Makin-Things/ESPHome-Brivis-Networker/Doc/PCB/v1.1/Layout_v1.1.png

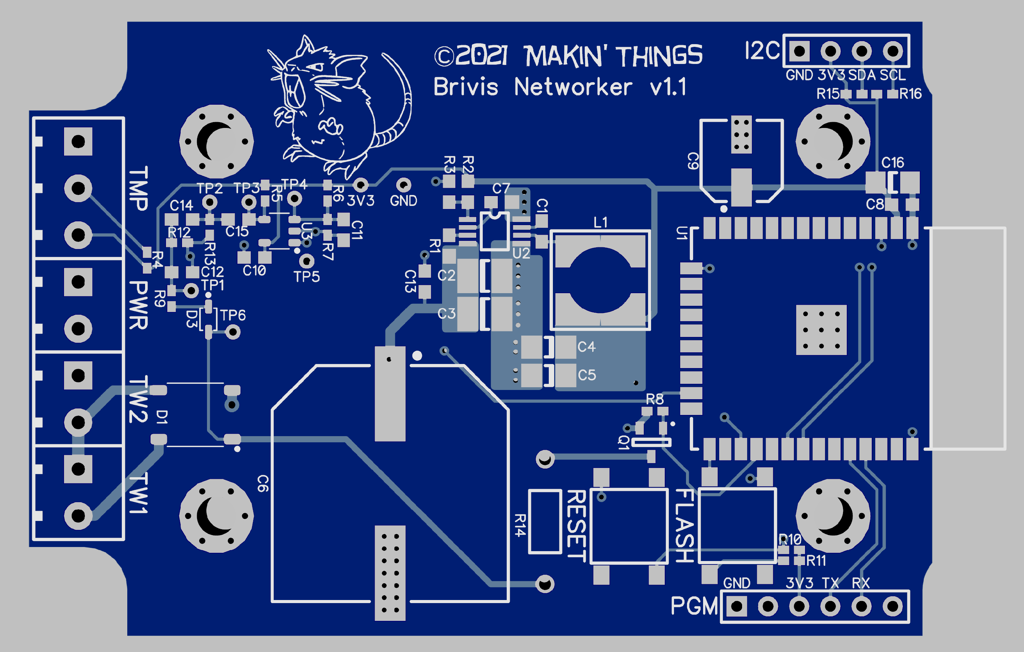
Doc/PCB/v1.1/Layout_v1.1.png
