Makin-Things/ESPHome-Brivis-Networker/(list of files, drawings)

Other design files:
DipTrace Files/Brivis Controller.dch
DipTrace Files/Brivis Controller.dip
