Makin-Things/ESPHome-Brivis-Networker/(threads)

Thread 1 (2022-11-02):

Support for LCD display and buttons?

linkedupbits, 2022-11-02:
Could this be extended to support a display and physical buttons?

If I understand correctly, this needs to replace the BR2 completely, so making this unit autonomous from Home Assistant (if HA is down) would be great.

Could the existing pin outs be used for this - IC2 for a display and buttons?

Makin-Things, 2023-12-29:
Depending on the version of NC you have you can in theory have it coexist the the existing controller. I think you need an NC-3 or later as that is where they added the ability to set a device id.
I won't be adding a screen or buttons as it is not something I need.

Closed 2023-12-29.

Thread 2 (2022-12-11):

evaporative coolers / Slave unit

garryf4, 2022-12-11:
Support for evaporative coolers, and to be setup as a slave unit to a master.
Prepared to help, are your boards ready for production?

Damien0505, 2023-01-16:
I would be willing to assist with this too.  Currently have a NC-6 controlling both ducted gas heater and evaporative cooler.

Makin-Things, 2023-01-16:
I have some extra boards and maybe the parts to populate them, not sure I have everything.  I am extremely limited for time for the next 4-6 weeks though.
I only have an NC-2 so there is no option for master/slave for me, so unable to test or write code for that. My understanding is that slaves just use a different address in the messages.
I also don't have cooling so I also have no idea what that sends.
The code I wrote has a mode where the software only listens on the bus (to allow logging of the data).

linkedupbits, 2023-01-29:
> I have some extra boards and maybe the parts to populate them, not sure I have everything. I am extremely limited for time for the next 4-6 weeks though.

Hi,
I would be keen to buy one of your boards (if you still have any left over)?
Any idea what would they cost - plus postage to New Zealand...
I am in no rush if you are busy.

kaza007, 2023-12-29:
Great work on this project Simon.
You have the gerber files available, any chance on supplying the parts list and layout diagram? Possibly a circuit diagram?
Otherwise happy to purchase a fully built pcb if that is easier.
Cheers,
Arthur (Melbourne)

Makin-Things, 2023-12-29:
Under Doc/PCB I have added a BOM and a PCB layout image. The PCB has the same silkscreen. In the BOM parts prefixed with E are Element14 part numbers, while those with D are Digikey part numbers. None of the parts are particularly critical so  substitions would probably be fine. The PCB was designed to mount in a Hammond case, but I can't find the part number right now.
The controller worked flawlessly again over winter. I have 9 bare PCB's still and am happy to post one out for a small fee (cover postage).

linkedupbits, 2023-12-29:
Do you need to reflow solder to assemble?
 I am looking at using pcbway / jlcbcp to manufacture and assemble the boards since I suspect I couldn’t adaquately actually make it.

Would it be possible to extract the offsets and BOM and the pick and place files out of the dip trace files?
https://jlcpcb.com/help/article/70-How-to-Generate-BOM-and-Pick-and-Place-File-in-DipTrace

Makin-Things, 2023-12-29:
I have a hatred of TH components these days so all parts other than connectors are SMD. That said surface mount isn't as scary as most people think. You can hand assemble, but I use a modified toaster oven to do the reflow.
I can export the data if needed and have no problem doing so.
Note that I have a day job that keeps me very busy so providing support will probably not be possible, other than proving the data I have.

Makin-Things, 2023-12-29:
The case that I designed the board to fit in to is this one.
https://www.digikey.com.au/en/products/detail/hammond-manufacturing/1591XXMSFLBK/2354700
I think any Hammond 1591 series boxes will work. I just cut out a section add one end for the cables to exit.

Makin-Things, 2023-12-29:
Also note that I had to do a bodge on my board to change it to use an external power supply as the ESP draws to much power while using wifi to use the available power from the heater network. I will document this later today, as well as do a quick update to the schematic and board layout in case anyone wants to have there own boards made.

Makin-Things, 2023-12-30:
@kaza007 I will email you soon, but have just annotated the layout for the v1.0 board with the bodge to use a separate power supply rather than trying to draw the power from the heater unit, which doesn't work.
@linkedupbits I have created a v1.1 board that adds an extra connector to the board to avoid having to do the bodge.
Under the PCB folder there are now folders for each version of the board.

kaza007, 2023-12-30:
Simon, don't feel pressured to get this done urgently. Please do it at your leisure. I am in no hurry :)

mspieth, 2025-03-08:
If anyone cares, here is a comms session for a NC6 with a Breezeair Evap cooler.
To get these logs I'm using ESPHOME in modbus mode and uart debugging enabled, on a ESP32-C3 with a RS485 board + some dupont wires, both from aliexpress. About $4.

[logs_evap_logs2.txt](https://github.com/user-attachments/files/19135085/logs_evap_logs2.txt)

Thread 3 (2023-01-11):

Can lend you a NC-6 Controller

bob-thetomato, 2023-01-11:
Hi Simon,
I would like to help you test this further, specifically the master/slave issue you mention. I couldn't see any other way to contact you (bit new to Github), so raising it as an issue.
I have a Brivis heater (and evap cooler), with an NC-6 controller and the wifi module. I run Home Assistant with some ESPHome modules (albeit simple ones).
I also have a spare NC-6 controller which I would be happy to lend you for testing. I see you are in Canberra as well.
Please reach out :)
Cheers,
Justin

Thread 5 (2025-01-29):

Do you sell versions of your 1.1 prototype board

harrylepotter-win, 2025-01-29:
Hey there! Fan of your work, but hopeless at anything involving a PCB, BOM and gerber files. Was wondering if you ever sold versions of your prototype board anywhere?

themormansound, 2025-02-03:
Hey harrylepotter-win, i've just ordered some unassembled pcbs... if i actually get some to work, I'm happy to post at cost. you're in AUS i'm guessing?

bob-thetomato, 2025-02-03:
Hey @themormansound, please keep us posted! I'd be interested in buying a board as well! 👍🏻
I'm in Aus.

harrylepotter-win, 2025-02-06:
@themormansound that'd be amazing! I am indeed based out of oz. Good luck with the smd-ing!

linkedupbits, 2025-02-07:
Would postage to NZ be too much of a hassle?
I am keen - but possibly on the wrong side of the Tasman…

themormansound, 2025-02-14:
Hey folks, I'm only making two, there was some issues with parts availability at jlcpcb. So apologies to those that have asked, but I won't be able to provide them for you.

I am going to have a shot at redesigning the pcb to make it more diy friendly, if i get that to work, you'll see this forked and updated

harrylepotter-win, 2025-02-14:
thanks for the update. Out of interest, are you using a hot air gun to mount the components? Might buy one and have a crack at building one myself

themormansound, 2025-02-14:
Nah, heatgun is a bit over the top. those 0402 components end up in the cracks in the floorboards if you do :D
I attempted a smt assembly option with jlcpcb, but they don't offer the inductor 'L1' or the esp32 chip in their inventory, so i've got them done without those two and will hand solder.

the jcl assembled versions are on their way to me, and if i can get around to ordering the remaining components and find some time to get it going i'll send one your way

In other news... The new design is progressing, and will use 0802 sized components, which you can hand solder with a bit of practice, and also will be using an off the shelf esp32 devkit v1 module which can be had cheaply on aliexpress or amazon.

ultimately, I'd love to end up with a project that can be sent to a pcb house, have them assemble the supporting components and then you just throw in the esp module and through hole components.

Jim

Makin-Things, 2025-02-14:
@themormansound my prototype board was hand assembled without issue. I am comfortable hand-soldering 0402, although I do have a homemade reflow oven which makes it even easier. If you are doing a different version of the board be very aware that  it was unreliable until I modded my PCB to accept external power for the ESP32. I was suffering brownouts whenever the wifi tried to send stuff. The Brivis heaters can't supply enough power on the 2 wire bus.

Makin-Things, 2025-02-23:
Also note that ESPHome 2025.2 has broken this, since they removed custom components and expect you to convert everything to an external component. The documentation for doing this is pathetic, a comment that says it is relatively simple to do, but absolutely now information on how to achieve it.

themormansound, 2025-02-24:
@Makin-Things Thanks for the info Simon. I won't be attempting the revision until i build your v1.1 design. When I do, it will use one of the esp32 dev boards powered via it's usb connector.

harrylepotter-win, 2025-05-07:
@themormansound just emailed you!
