Makin-Things/ESPHome-Brivis-Networker/(commit log)

2022-07-19 Add the rest of the files.
    [Brivis Controller.dch, Brivis Controller.dip, Brivis Decode.xlsm, Brivis Protocol.xlsx]
2022-07-20 Improve excel doco.
    [Brivis Protocol.xlsx]
2022-09-18 Update code and add more config
    [Brivis Decode.xlsm, Brivis Protocol.xlsx]
2023-12-29 Add layout and BOM.
    [Bom.csv]
2023-12-29 Add pick and place file.
    [PnP.csv]
2023-12-30 Created v1.1 and annotated bodge for v1.0.
    [Bom_v1.0.csv, Bom_v1.1.csv, Brivis Controller.dch, Brivis Controller.dip, PnP_v1.0.csv, PnP_v1.1.csv]
